KentumRIT/PrusaXL-4th-Axis-Cylindrical-Printing/4th-Axis-Mechanical/readme.md

# Goal
We need to make calculations for gear slop, angular resolution, linear resolution for multiple strategies of producing 4th axis (theta) motion that is scalable to multple madrals.
- Identify 3 different strategies to make calculations for.
