KentumRIT/PrusaXL-4th-Axis-Cylindrical-Printing/Printing-on-McKibben/Straight Bar/Straight Bar.3mf

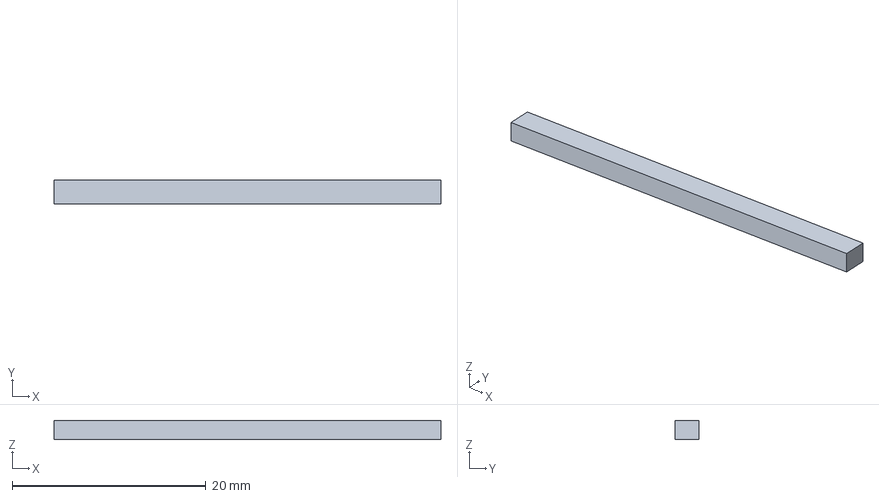
[picture p1: CAD file, 2026-03-18]
Printing-on-McKibben/Straight Bar/Straight Bar.3mf
40.0 x 2.50 x 2.00 mm
