KentumRIT/PrusaXL-4th-Axis-Cylindrical-Printing/4th-Axis-Control/Theta-Control-Via-Serial/journal.md

# Goal
For this method of 4th axis control, I'll be sending angular position data to an external microcontroller via serial G-code command `M118`, and the microcontroller will then drive the θ axis motor through a motor controller.

# Potential Solutions
## Title
### Description
