KentumRIT/PrusaXL-4th-Axis-Cylindrical-Printing/(commit log)

2026-03-18 Create Ideation.md
    This doc will track brainstorming for 4th axis control possibilities
2026-03-18 Update Triggering-Control-Switching.md
    updated goal
2026-03-18 Create Testing-Z-Repeatability-With-Interrupted-Motor-Power
2026-03-18 Update Testing-Z-Repeatability-With-Interrupted-Motor-Power.md
    minor fix
2026-03-18 Transferred files from lab desktop over
    [Straight Bar.3mf]
2026-03-19 Trying to get Z to turn off during printing
2026-03-23 Working on reading serial via esp32
2026-03-24 different control board ideas
2026-05-20 Create 4th-Axis-Mechanical
    File for mechanical side of 4th axis printing on the McKibben muscles.
2026-09-10 updated files
    [Important Parameters.txt]
